AidanC22/GearDemo/media/assembling-1.jpg

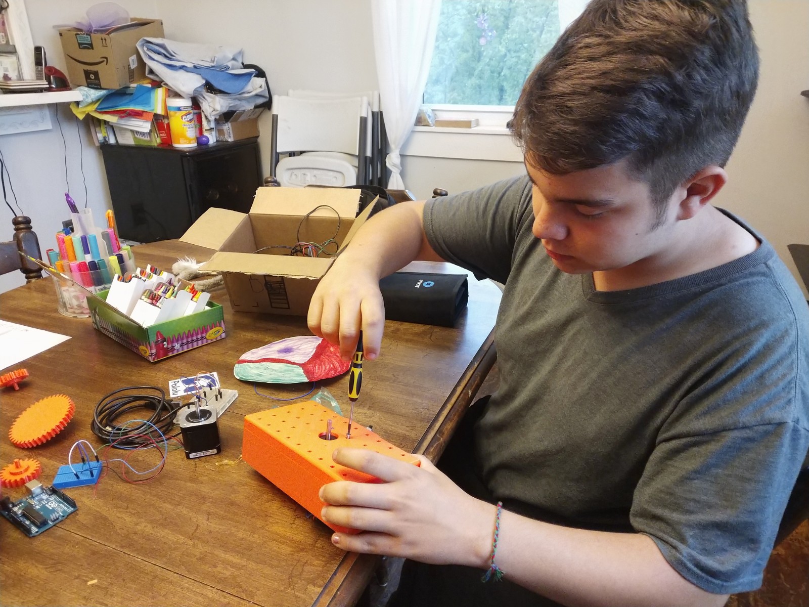
media/assembling-1.jpg
