AidanC22/GearDemo/media/assembling-2.jpg

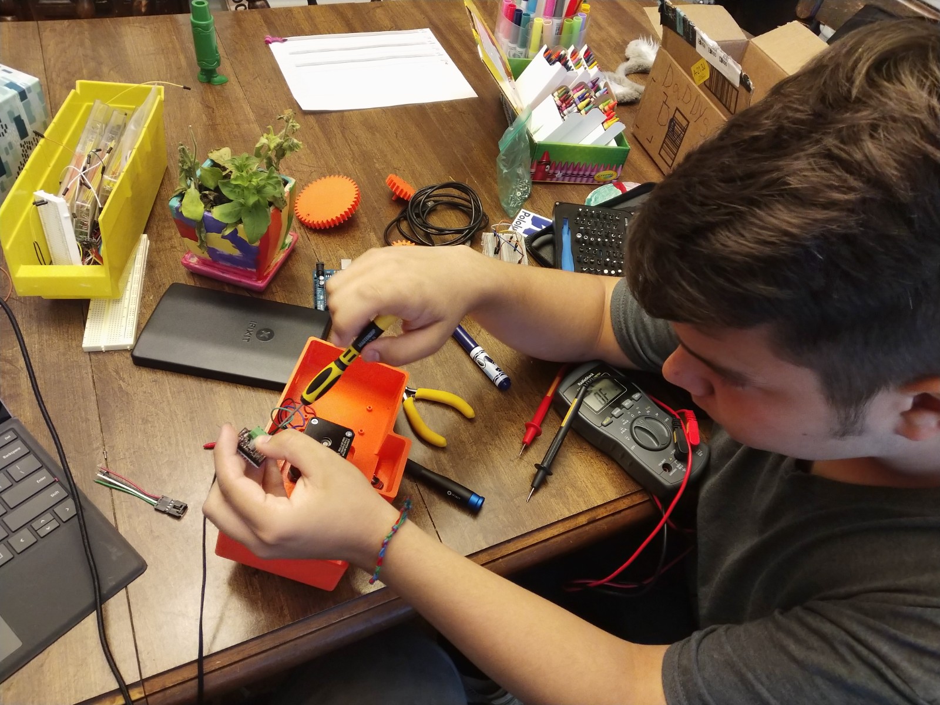
media/assembling-2.jpg
