AidanC22/GearDemo/media/soldering-1.jpg

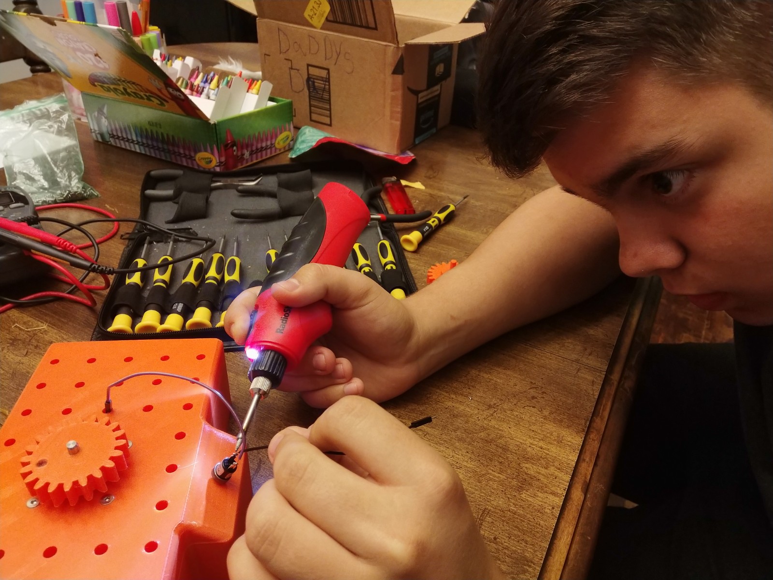
media/soldering-1.jpg
