AidanC22/GearDemo/media/soldering-2.jpg

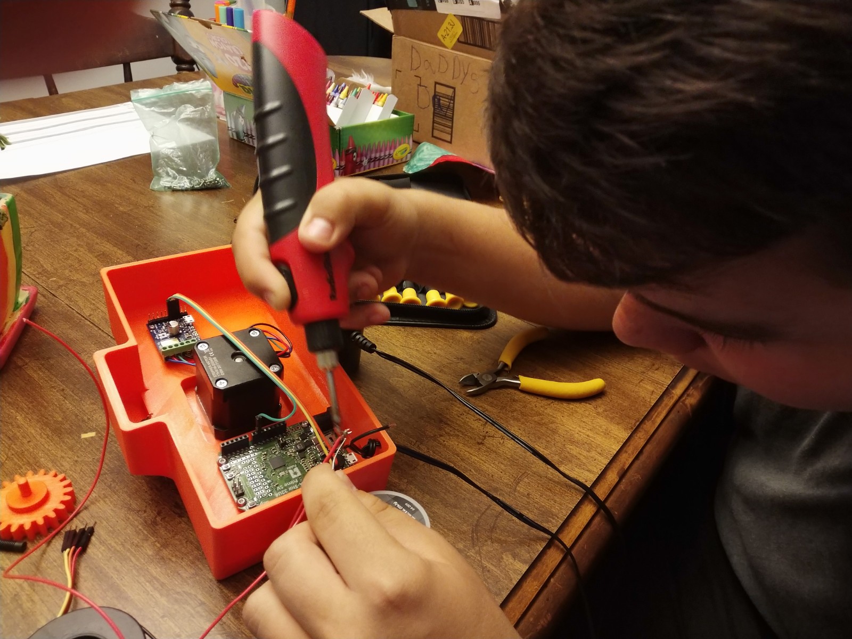
media/soldering-2.jpg
