AidanC22/GearDemo/(commit log)

2019-06-03 Add details for configuring Arduino IDE
2019-06-03 Added screen-shot of 3d print slicer.
2019-06-03 Added photo of part printing.
2019-06-03 Added more assembly photos
2019-06-04 Initial version of gear-demo firmware.
2019-06-04 Increased startup delay to 2 seconds as the power brick may take a bit to power up the Tic T825.
